Edgeberry/Edgeberry-HWCartridge-EdgeExplorer/examples/Crowtail-Demo/README.md

# Edge Explorer demo with Crowtail modules



Two Edgeberry devices with the Edge Explorer Hardware Cartridge, and some Elecrow Crowtail modules Lorem ipsum dolores si amet ...

<br clear="right"/>

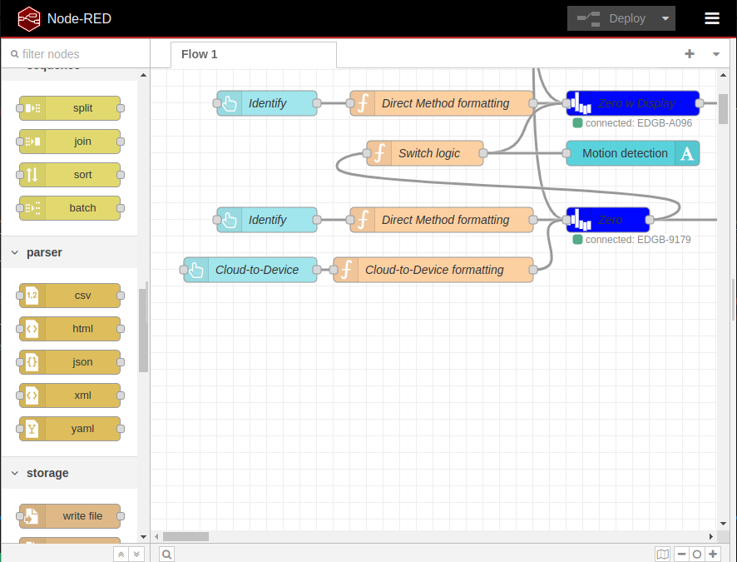
[picture p2: examples/Crowtail-Demo/nodered-flows.png]


The Node-RED programming environment Lorem ipsum ...

<br clear="right"/>

ToDo...
