Edgeberry/Edgeberry-HWCartridge-EdgeExplorer/faceplate/Edgeberry_Hardware_Cartridge_faceplate.step

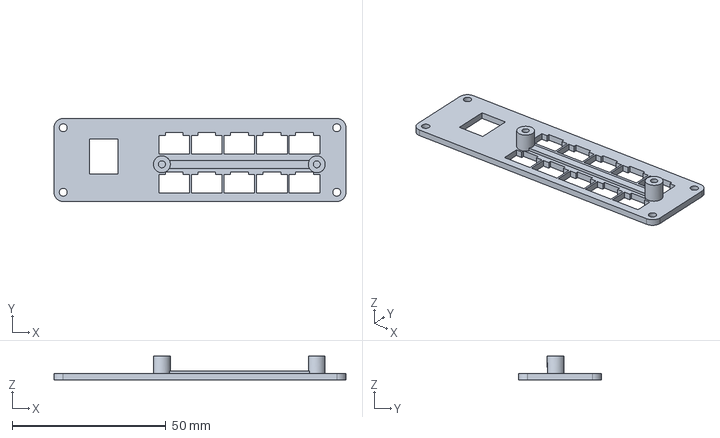
[picture p3: CAD file, 2025-03-29]
faceplate/Edgeberry_Hardware_Cartridge_faceplate.step
95.0 x 27.0 x 7.70 mm
