Edgeberry/Edgeberry-HWCartridge-EdgeExplorer/(list of files, cad)

Other CAD files:
faceplate/Edgeberry_Hardware_Cartridge_faceplate.FCStd
