Edgeberry/Edgeberry-HWCartridge-EdgeExplorer/(commit log)

2025-03-06 Setting up basics
    [Edgeberry_Explorer_Cartridge.kicad_pcb, Edgeberry_Explorer_Cartridge.kicad_sch]
2025-03-06 Project hierarchy improvement
    [Edgeberry_Explorer_Cartridge.kicad_pcb, Edgeberry_Explorer_Cartridge_Top.kicad_pcb, Edgeberry_Explorer_Cartridge_Top.kicad_sch]
2025-03-07 Major update: dimensions, routing, ...
    [Edgeberry_Explorer_Cartridge.kicad_pcb, Edgeberry_Explorer_Cartridge.kicad_sch, Edgeberry_Explorer_Cartridge_Top.kicad_pcb, Edgeberry_Explorer_Cartridge_Top.kicad_sch]
2025-03-07 SPI level shifters + routing
    [Edgeberry_Explorer_Cartridge.kicad_pcb, Edgeberry_Explorer_Cartridge.kicad_sch]
2025-03-08 Electrical wiring complete
    [Edgeberry_Explorer_Cartridge.kicad_pcb, Edgeberry_Explorer_Cartridge.kicad_sch]
2025-03-08 First finished version
    [Edgeberry_Explorer_Cartridge.kicad_pcb, Edgeberry_Explorer_Cartridge.kicad_sch, Edgeberry_Explorer_Cartridge_Top.kicad_pcb]
2025-03-08 Manufacturing preparation
    [Edgeberry_Explorer_Cartridge.kicad_pcb, Edgeberry_Explorer_Cartridge_Top.kicad_pcb]
2025-03-08 Bugfix + final cleanup
    [Edgeberry_Explorer_Cartridge.kicad_pcb, Edgeberry_Explorer_Cartridge.kicad_sch, Edgeberry_Explorer_Cartridge_Top.kicad_pcb, Edgeberry_Explorer_Cartridge_Top.kicad_sch]
2025-03-09 Final hardware optimizations
    [Edgeberry_Explorer_Cartridge.kicad_pcb, Edgeberry_Explorer_Cartridge_Top.kicad_pcb, Edgeberry_Explorer_Cartridge_Top.kicad_sch]
2025-03-09 Critical error in port connector footprints fixed
    [Edgeberry_Explorer_Cartridge.kicad_pcb, Edgeberry_Explorer_Cartridge_Top.kicad_pcb, Edgeberry_Explorer_Cartridge_Top.kicad_sch]
2025-03-12 Faceplate design
    [Edgeberry_Explorer_Cartridge.kicad_pcb, Edgeberry_Explorer_Cartridge_Top.kicad_pcb]
2025-03-16 Faceplate improvements
    [Edgeberry_Explorer_Cartridge.kicad_pcb]
2025-03-29 Faceplate 3D model
    [Edgeberry_Hardware_Cartridge_faceplate.FCStd, Edgeberry_Hardware_Cartridge_faceplate.step]
2025-04-01 ReadMe: Pull-up resistor warning
2025-10-26 Documentation: Assembly image
